AtaS-TheEngineer/IzolasyonIzleme/SCH_İzolasyon İzleme Cihazı_1-P1_2025-07-05.png

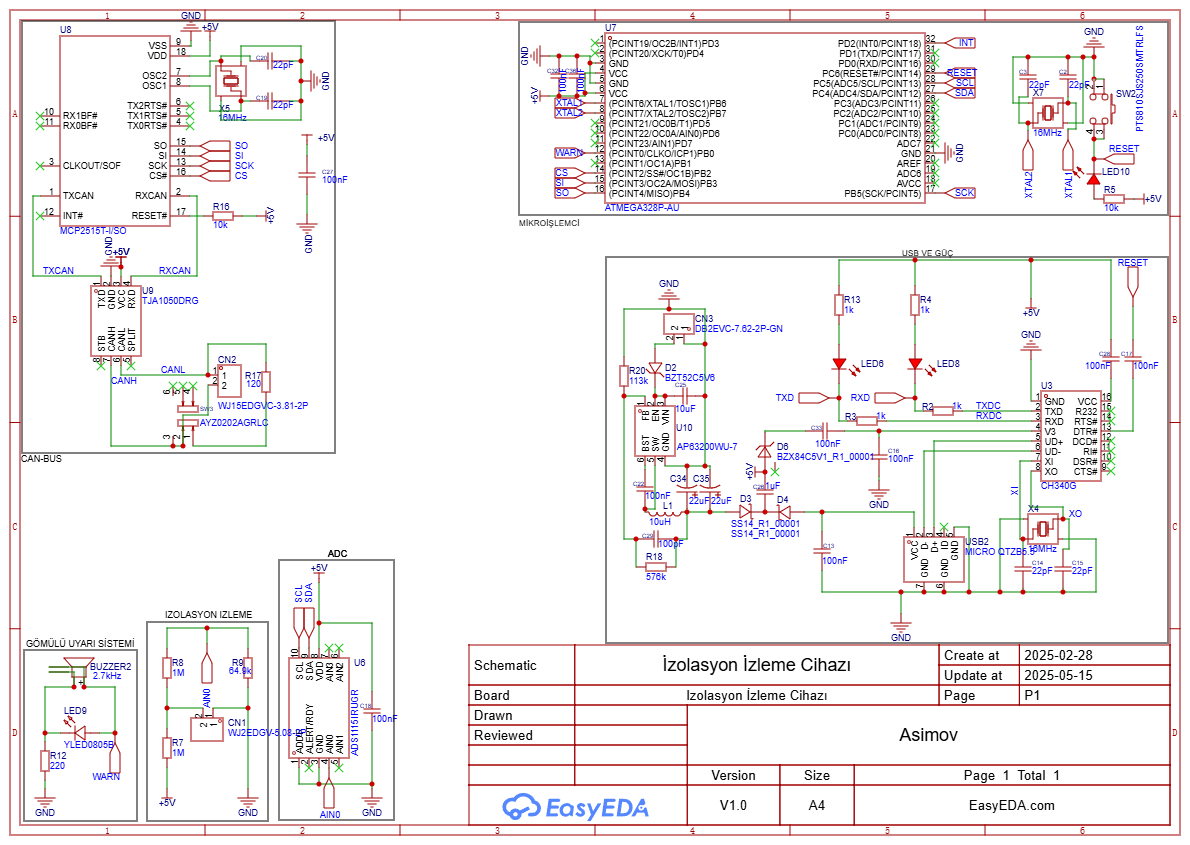
SCH_İzolasyon İzleme Cihazı_1-P1_2025-07-05.png
