AtaS-TheEngineer/IzolasyonIzleme/PCB_PCB2_1_2025-07-04.pdf

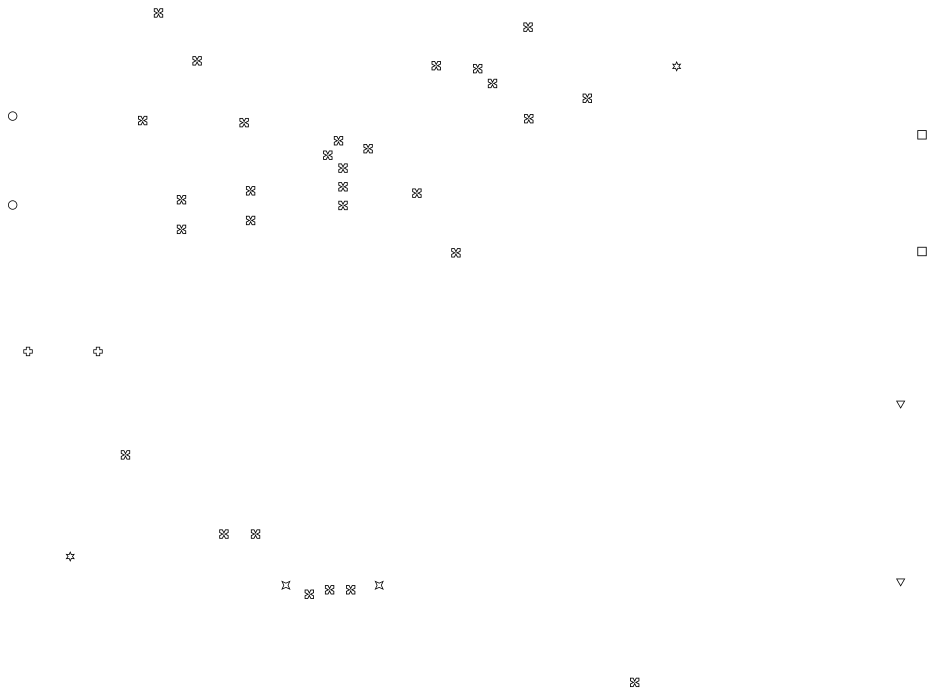
[picture p13: page 3]
