AtaS-TheEngineer/IzolasyonIzleme/PCB_PCB2_1_2025-07-04.pdf

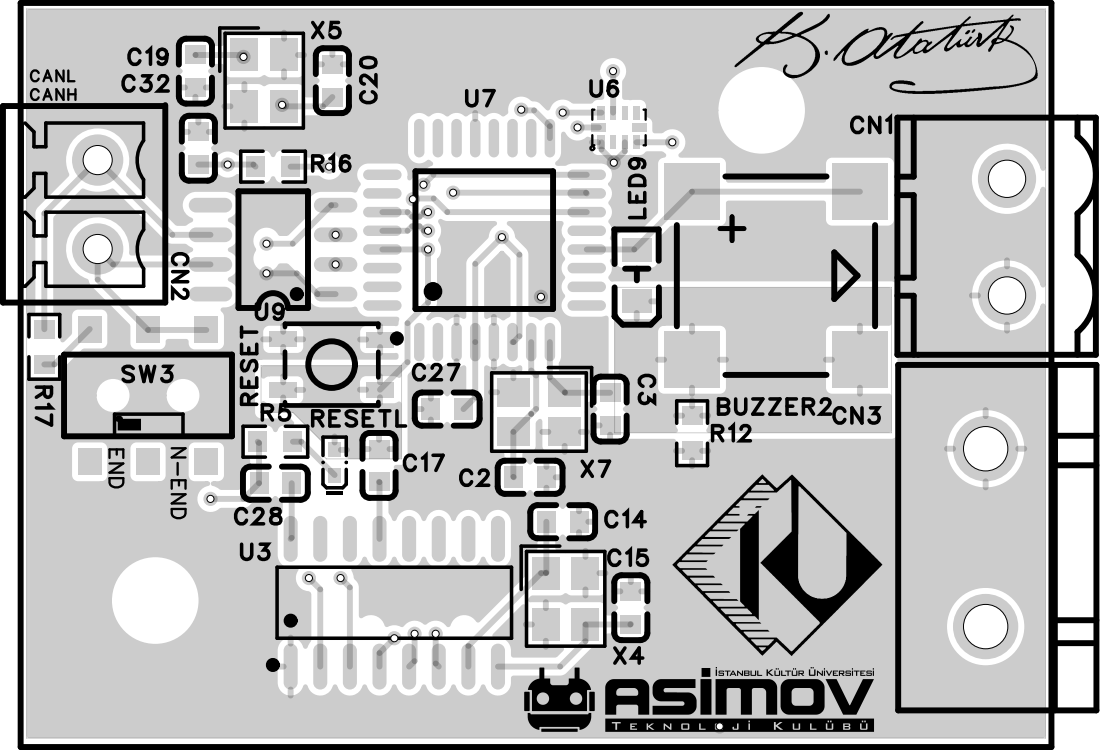
[picture p11: page 1]

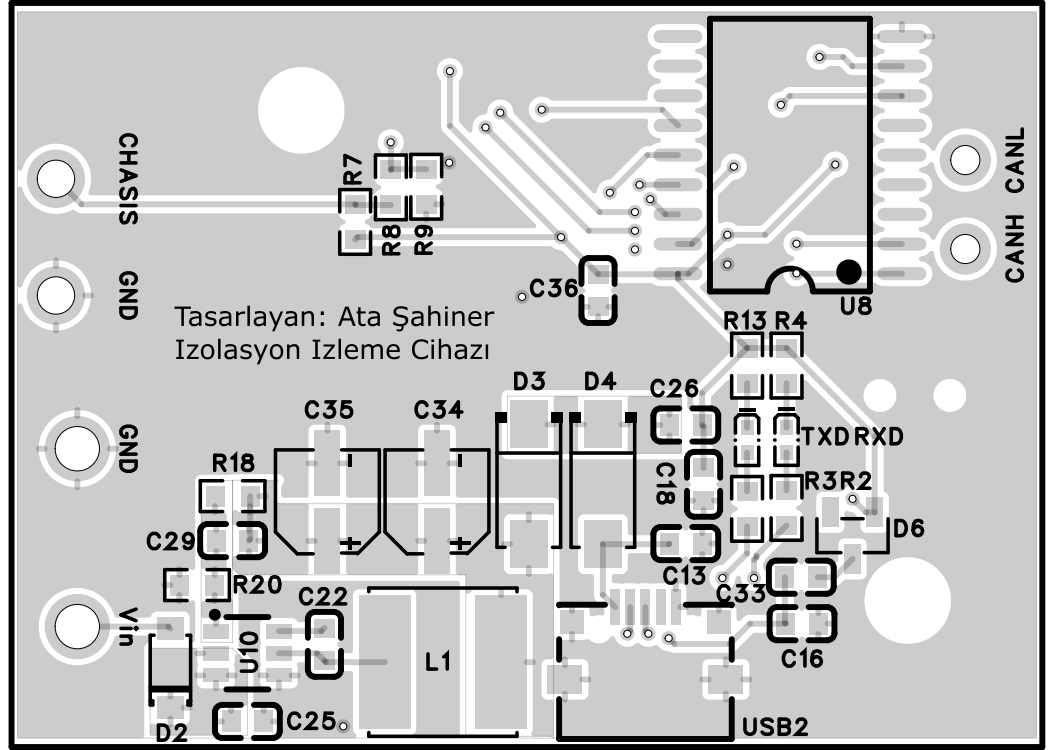
[picture p12: page 2]

GND Vin CHASIS GND
